antonmeyer/ArduinoDTMF/picture/T50_Detail.JPG

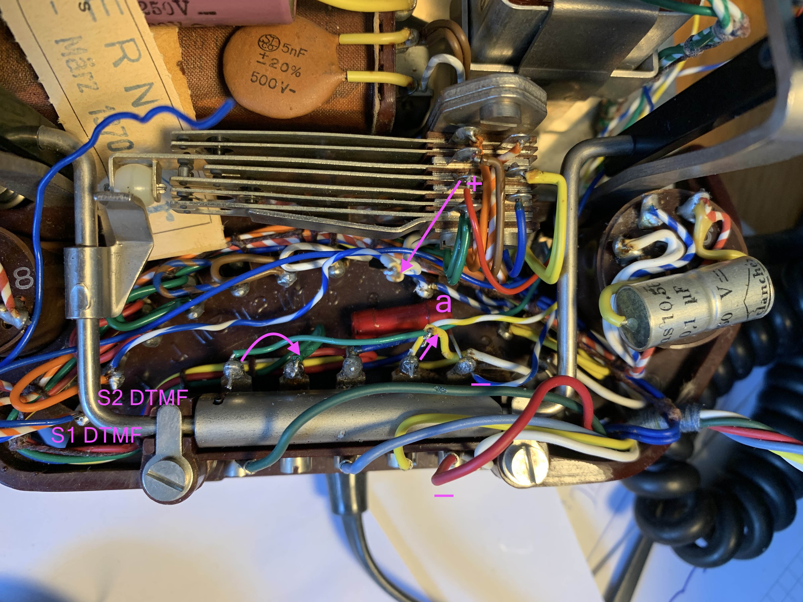
picture/T50_Detail.JPG
