antonmeyer/ArduinoDTMF/picture/T50_DTMF_Schema.jpeg

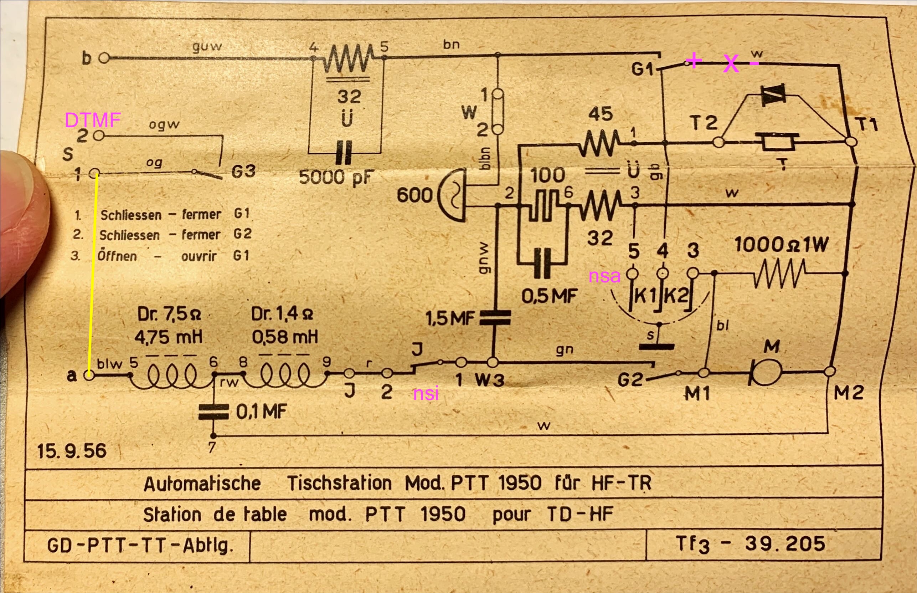
picture/T50_DTMF_Schema.jpeg
