antonmeyer/ArduinoDTMF/picture/ArduinoDTMF_Schaltplan.png

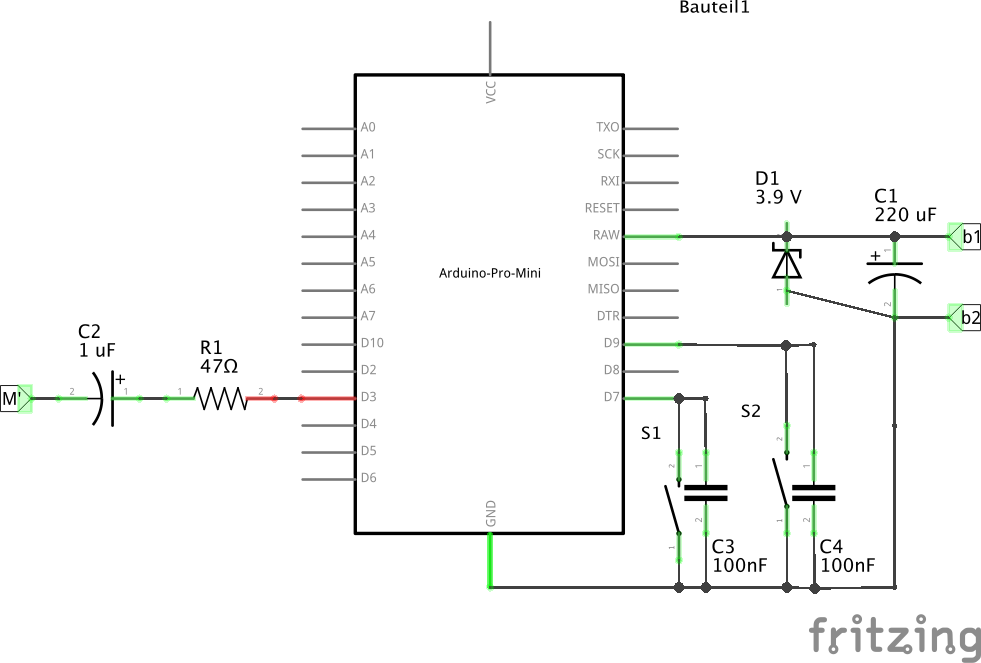
picture/ArduinoDTMF_Schaltplan.png
