antonmeyer/ArduinoDTMF/picture/Ardunino_pro_mini.JPG

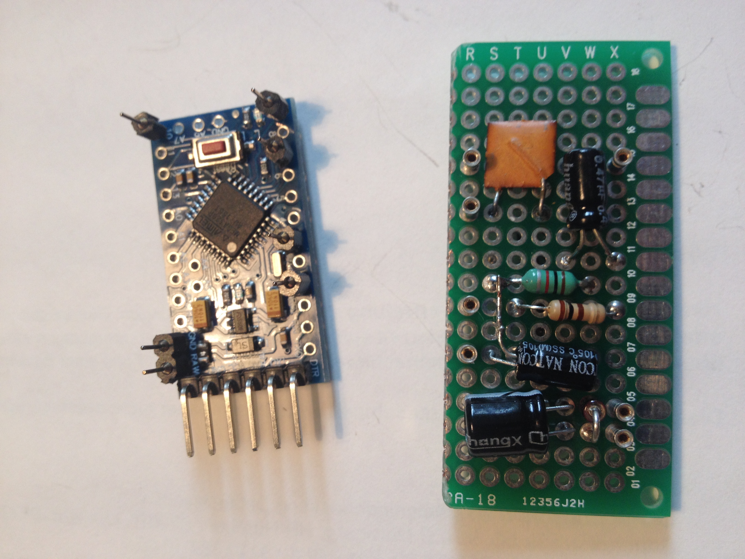
picture/Ardunino_pro_mini.JPG
