antonmeyer/ArduinoDTMF/picture/T28.JPG

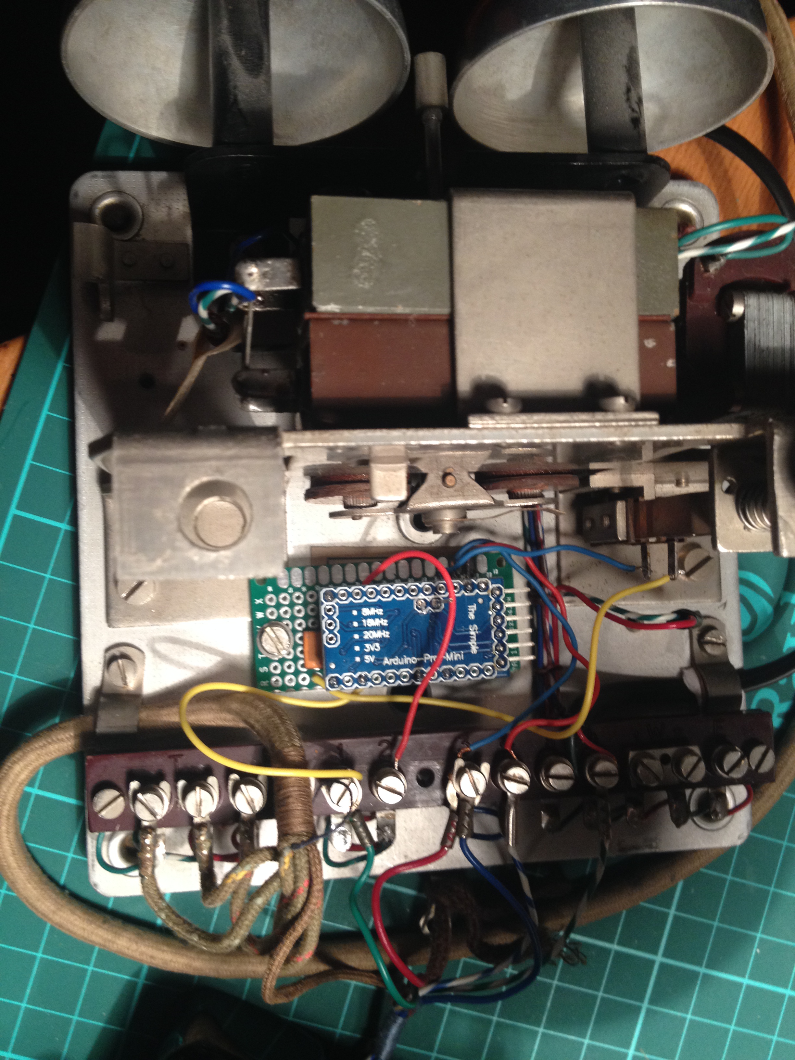
picture/T28.JPG
