antonmeyer/ArduinoDTMF/picture/T50_hinten.JPG

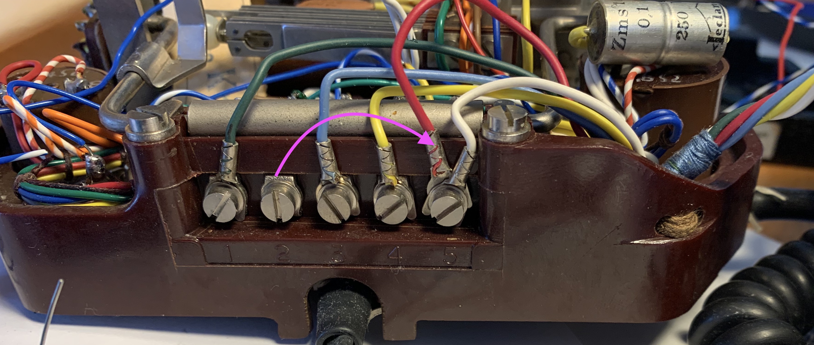
picture/T50_hinten.JPG
