antonmeyer/ArduinoDTMF/picture/T50_oben.JPG

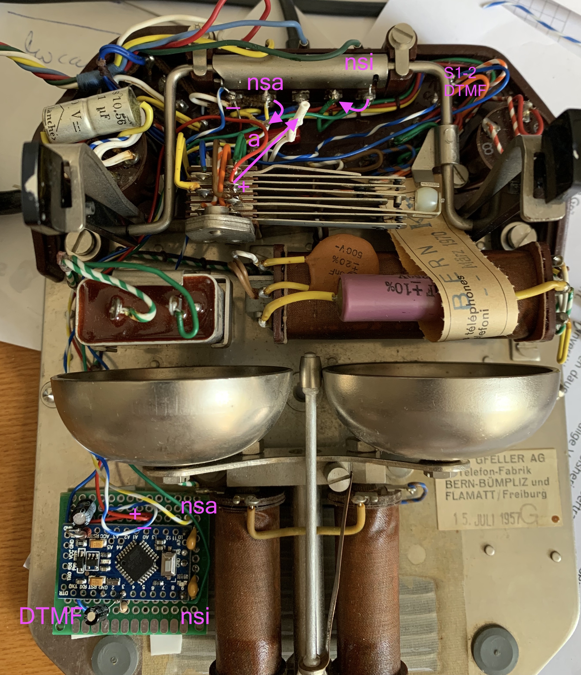
picture/T50_oben.JPG
