antonmeyer/ArduinoDTMF/picture/W50_DTMF.png

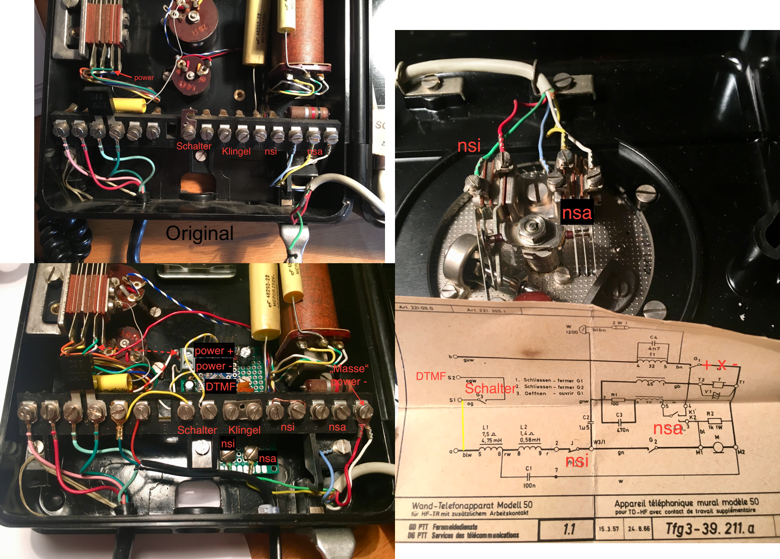
picture/W50_DTMF.png
