antonmeyer/ArduinoDTMF/IWV_DTMF_duino.ino

#include <EEPROM.h>
#include <Button.h>
#include <PinChangeInterruptSettings.h>
#include <PinChangeInterruptPins.h>
#include <PinChangeInterruptBoards.h>
#include <PinChangeInterrupt.h>


//*************************************************************************
//** EEPROM stuff
//** we store short dial numbers
//** in the setup we check if storage was initialized
//** as we have enough space we reserve 20 Byte per number and store it as String
//*****************************************************************************

static const char EEPROM_init_string[] =  "IWV01102016";

char phoneNumber[20];

//***************************************************************************
//** DTMF Generator based on ATMEL AVR-314 Application note
//***************************************************************************

#define  prescaler  1                // timer2 prescaler
#define  N_samples  128              // Number of samples in lookup table
#define  Fck        F_CPU/prescaler   // Timer2 working frequency

#define dtmfopin	3			//dtmf output pin 3 = OC2B, timer2
#define IWVpin		11				// counts the impulse

//************************************************************************
//** NSA switch is closed when the rotary disk is moved
//** if user hold the disk for a longer time than the state is changed
//** advantage: no need for extra button for extra function, 1 finger usage
//** disadvantage: tricky timing
//** stop nsa time measurement as soon IWVcounter > 0
//** giving user feedback with tone might interfer with first IWV impulse; both use ISR
//**	-> IWV ISR disable DTMF ISR
//
//** To dial *: dial 7 hold the dial disk for NSA_short wait for the tone (600Hz, 50ms) and release the disk
//** To dial # : sames as above with 9
//** To dial short numbers: same as above with 1..5
//** To program short number: dial storage dial place 1..5; hold disk NSA_long, wait for tone 1KHz, 300ms
//**							release; than enter number, wait until timeout tone
//*************************************************************************



Button nsa_switch(8);
unsigned long nsa_start; // used for measure the duration
unsigned short nsa_state = 0; //define the state
#define NSA_short 1500 //ms to enter state 1
#define NSA_long 5000 // ms to enter state 2
#define STATE2_TIME_OUT 4000

//************************** SIN TABLE *************************************
// Samples table : one period sampled on 128 samples and
// quantized on 7 bit
//**************************************************************************
const unsigned char auc_SinParam [128] = {
	64,67,70,73,76,79,82,85,88,91,94,96,99,102,104,106,109,111,113,115,117,118,120,
	121,123,124,125,126,126,127,127,127,127,127,127,127,126,126,125,124,123,121,120,
	118,117,115,113,111,109,106,104,102,99,96,94,91,88,85,82,79,76,73,70,67,64,60,57,
	54,51,48,45,42,39,36,33,31,28,25,23,21,18,16,14,12,10,9,7,6,4,3,2,1,1,0,0,0,0,0,
0,0,1,1,2,3,4,6,7,9,10,12,14,16,18,21,23,25,28,31,33,36,39,42,45,48,51,54,57,60};

//***************************  x_SW  ***************************************
//Table of x_SW (excess 8): x_SW = ROUND(8*N_samples*f*510/Fck)
//ToDo calculate values in the preprocessor ..but be careful rounding errors
// might violate 1.5% frequency tolerance of DTMF
//**************************************************************************

#define SWC(x)  ((x)*128.0*8*510/Fck)
//high frequency (column)
//1209hz  ---> x_SW = 79
//1336hz  ---> x_SW = 87
//1477hz  ---> x_SW = 96
//1633hz  ---> x_SW = 107

const char auc1KHz = SWC(1000);
const char auc600Hz = SWC(600);

#if Fck == 8000000 // 8 MHz
const unsigned char auc_frequencyH [4] = {79,87,96,107}; //8MHz
const unsigned char auc_frequencyL [4] = {46,50,56,62}; //8MHz
#else
const unsigned char auc_frequencyH [4] = {40, 44, 48,53}; //@16MHz
const unsigned char auc_frequencyL [4] = {23, 25, 28, 31}; //@16MHz
#endif
//const unsigned char auc_frequencyH [4] = {SWC(1209), SWC(1336), SWC(1477), SWC(1633)};
//low frequency (row)
//697hz  ---> x_SW = 46
//770hz  ---> x_SW = 50
//852hz  ---> x_SW = 56
//941hz  ---> x_SW = 61

//

const String alldigits = "123A456B789C*0#D"; // position for lookup into Freq. Table

//**************************  global variables  ****************************
volatile unsigned char x_SWa = 0x00;               // step width of high frequency
volatile unsigned char x_SWb = 0x00;               // step width of low frequency
unsigned int  i_CurSinValA = 0;           // position freq. A in LUT (extended format)
unsigned int  i_CurSinValB = 0;           // position freq. B in LUT (extended format)
unsigned int  i_TmpSinValA;               // position freq. A in LUT (actual position)
unsigned int  i_TmpSinValB;               // position freq. B in LUT (actual position)

volatile unsigned char iwvcounter =0;
volatile unsigned long last_impulse_at = 0;

//**************************************************************************
// Timer overflow interrupt service routine for DTMF sine wave
//**************************************************************************
ISR (TIMER2_OVF_vect)
{
	if (x_SWb) { // dual tone
		// move Pointer about step width ahead
		i_CurSinValA += x_SWa;
		i_CurSinValB += x_SWb;
		// normalize Temp-Pointer
		i_TmpSinValA  =  (char)(((i_CurSinValA+4) >> 3)&(0x007F));
		i_TmpSinValB  =  (char)(((i_CurSinValB+4) >> 3)&(0x007F));
		// calculate PWM value: high frequency value + 3/4 low frequency value
		OCR2B = (auc_SinParam[i_TmpSinValA] + (auc_SinParam[i_TmpSinValB]-(auc_SinParam[i_TmpSinValB]>>2)));

		} else { // single tone

		i_CurSinValA += x_SWa;
		i_TmpSinValA  =  (char)(((i_CurSinValA+4) >> 3)&(0x007F));
		OCR2B = auc_SinParam[i_TmpSinValA];
	}
}

// counts the HW impulse from IWVpin on the RISING edge
void ISR_countImpulse (void)
{	//noInterrupts(); ToDo not sure if this is needed
	
	if ((millis() - last_impulse_at) > 25) {
		// we are in the middle of a rotating disk
		// we check for bouncing, normal impulse take 100 ms (60/40)
		// if diff is too short we ignore it
		iwvcounter++;
		last_impulse_at = millis();
	};
	//interrupts();

}


void dialNumber(String nrstr) {
	char digitchar;

	for (byte i=0; i< nrstr.length(); i++) {
		digitchar = nrstr.charAt(i); //get char by char from dial number string
		dialDigit(digitchar);
	}
}

void dialDigit(char digitchar) {

	unsigned short digitpos = alldigits.indexOf(digitchar); //get position

	x_SWa = auc_frequencyH[(digitpos & 0x03)];	// column of 4x4 DTMF Table
	x_SWb = auc_frequencyL[(digitpos /4)]; //row of DTMF Table

	pinMode(dtmfopin, OUTPUT); //output pin ready
	bitSet(TIMSK2,TOIE2); // timer interrupt on
	delay (100); //tone duration
	//tone off
	pinMode(dtmfopin, INPUT); //make it high impedance
	bitClear(TIMSK2,TOIE2);
	delay (50); // pause
}

void sendTone (char auc_tone, unsigned int duration) {
	
	// a bit ugly hack to reuse the DTMF tone generation ISR
	x_SWa = auc_tone;
	x_SWb = 0; //single tone

	pinMode(dtmfopin, OUTPUT); //output pin ready
	bitSet(TIMSK2,TOIE2); // timer interrupt on
	delay (duration); //tone duration
	//tone off
	pinMode(dtmfopin, INPUT); //make it high impedance
	bitClear(TIMSK2,TOIE2); //switch off ISR

}

//**************************************************************************
// Initialization
//**************************************************************************
void setup ()
{
	//Serial.begin(19200); //for debug purpose

	//setup impulse counter ISR
	pinMode(IWVpin, INPUT_PULLUP);
	attachPCINT(digitalPinToPCINT(IWVpin),  ISR_countImpulse, RISING);
	
	noInterrupts();           // disable all interrupts
	//ToDo is that correct?
	TCCR2A = 0;
	TCCR2B = 0;
	TCNT2  = 0;
	TCCR2A = (1<<COM2B1)+(1<<WGM20);   // non inverting / 8Bit PWM
	TCCR2B = (1 << CS20);  // CLK/1
	bitClear(TIMSK2,TOIE2);
	interrupts();             // enable all interrupts
	// timer interrupt is enabled during dialing: bitSet(TIMSK2,TOIE2)
	
	nsa_switch.begin();
	iwvcounter=0;

	// EEPROM init check
	unsigned short iee;
	for (iee =0; iee < sizeof(EEPROM_init_string); iee++) {
		if (EEPROM.read(iee) != EEPROM_init_string[iee]) break;
	}
	//if we did not reach the end of the compare string, we (re)initial the EEPROM storage structure
	if (iee < sizeof(EEPROM_init_string)) {
		//Serial.println("init EEPROM");

		EEPROM.put(0,EEPROM_init_string);
		for (iee=1; iee < 6; iee++) { // 1..5
			EEPROM.put(iee*sizeof(phoneNumber),0); //set the phone
		}
	}
	pinMode(LED_BUILTIN, OUTPUT);

}

unsigned long diff_iwv = 0;
unsigned long nsa_diff = 0;
unsigned short newdigit = 0;
String numberstr = String("");
String numberstr2 =  String("");

unsigned long lastdigittime = 0; //when has the last digit been dialed? reset the state 2

void loop ()
{
	
		//nsa switch check and timing check here; do not forget ivw counter

	//finish state 2
	if ((nsa_state == 2) && ((millis() - lastdigittime) > STATE2_TIME_OUT)) {

		nsa_state = 0; // reset the state
		//get the storage place (first digit)
		//store the remaining string at position

		//Serial.println(numberstr2);
		boolean store_ok = false;

		if ((numberstr2.length() > 1) && (numberstr2.length() < 20)){
			
			unsigned short pos = numberstr2.charAt(0) - '0';
			numberstr2.remove(0,1);
			if ((pos > 0) && (pos <6)) {
				numberstr2.toCharArray(phoneNumber,sizeof(phoneNumber));
				EEPROM.put(pos*sizeof(phoneNumber), phoneNumber);
				store_ok = true;
			}
		}
	
		//send notification tone
		if (store_ok) {
			sendTone(auc600Hz, 300); delay(50);
			sendTone(auc1KHz, 300);
		}
		else {
			sendTone(auc600Hz, 100); delay(50);
			sendTone(auc600Hz, 100); delay(50);
			sendTone(auc600Hz, 100); delay(50);
			sendTone(auc600Hz, 100); delay(50);			
		}
		//clear numberstring
		numberstr2.remove(0); //deletes the String but keeps the object
	} // reset state 2

	
	if (iwvcounter == 0) { //to make sure IWV has not started = disk not released
		
		if ((nsa_switch.read() == Button::PRESSED) && (nsa_state < 2)) {
			if (nsa_switch.pressed()) nsa_start = millis(); //get the one shot event

			nsa_diff = millis() - nsa_start;
			
			if (nsa_diff > NSA_long ) { // we enter 2nd level
				nsa_state = 2;
				numberstr.remove(0); //delete the numberstring
				lastdigittime = millis (); // we start state 2
				sendTone(auc1KHz, 300); //notify the user that he can release the disk
				} else if (( nsa_diff > NSA_short) && (nsa_state < 1)){
				// we enter 1st level
				nsa_state = 1;
				sendTone(auc600Hz, 100); //notify the user that he can release the disk
			}
			// it is to short we have to wait
		} //nsa_switch pressed

		} else { // there has been IWV impulse iwvcounter != 0
		//we had a race condition, so make it atomic
		// ToDo could we double check the race??
		noInterrupts();
		diff_iwv = millis () - last_impulse_at;
		interrupts();
		if ( (diff_iwv > 300)) {
			// next impulse would belong to a new digit
			newdigit = iwvcounter%10; // 10 -> 0
			iwvcounter = 0; //reset the counter for a new digit
			lastdigittime = millis();

			switch (nsa_state) { //in which dial mode we are?

				case 0 : dialDigit(newdigit +'0');
				break;

				case 1 : numberstr = shift_func (newdigit);
				dialNumber(numberstr);
				//Serial.println(numberstr);
				nsa_state = 0; // one shot function
				break;

				case 2 :  //add digit to number string
				numberstr2.concat(String(newdigit, DEC));
				break; // we handle here the storage
			}
			
			//Serial.print(numberstr);			
		}

	}
}


String shift_func (unsigned short digit) {

	String result = "";

	if (digit == 7) return "*";
	
	if (digit == 9) return "#";

	// 1..5 get stored number at position digit
	if ((digit > 0) && (digit <6)) {
		
		EEPROM.get(digit*sizeof(phoneNumber),phoneNumber);
		result = String(phoneNumber);
	}

	return result;
}
