antonmeyer/ArduinoDTMF/(commit log)

2016-08-14 Pin 4 -> Pin 3, RLC Values have changed
2016-09-17 add example for Impulse Wähl Verfahren to DTMF converter with arduino
2016-09-17 clean up git handling errors
    [IWV_DTMF_duino.ino]
2016-09-19 version compiles with new NSA switch
2016-09-30 beta version with short number storage
    [IWV_DTMF_duino.ino]
2017-01-02 PIN layout changed
